betich/tastebox/(commit log)

2026-04-14 feat: update arduino sketches
2026-04-14 feat: implement I2C communication for cooker and plating devices, update requirements
2026-04-21 feat: add Cutter and Ingredient devices with I2C communication
    - Implemented CutterDevice class for controlling the cutter hardware via I2C.
    - Implemented IngredientDevice class for managing ingredient dispensing via I2C.
    - Updated PlatingArmDevice to reflect changes in the I2C register map and functionality.
    - Modified master controller to include new devices in the demo and initialization process.
    - Added platformio configuration and main logic for Cutter and Ingredient nodes.
    - Refactored existing code for better readability and maintainability.
2026-05-03 feat: LCD display, admin debug UI, I2C consistency fixes, RPi setup script
    - Fix missing REG_SET_PAN_LO/REG_ARM_DUR_LO (plating) and
    REG_LID_DUR_LO/REG_PST_DUR_LO (cutter) constant definitions;
    update CLAUDE.md register maps to reflect actual pan+arm firmware
    - Add controller/display.py: ST7735 driver via luma.lcd with
    IDLE/PERSONALIZING/COOKING/FINISHED states; cooking state ticks
    an elapsed timer on the display every second
    - Add controller/server.py: Flask HTTP server exposing full REST API
    for all four I2C devices plus POST /state to drive the LCD;
    started as a daemon thread from master.py
    - Add web/app/routes/admin.tsx: /admin debug page with virtual
    gamepad UI (D-pad,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
    [display.py, esp32_drive.ino, main.cpp, master.py, serial_bus.py]
2026-05-03 fix: skip offline I2C devices instead of crashing in demo
    probe_all now returns per-device results so main does not re-probe;
    demo guards each device section and prints OFFLINE skipped for
    missing nodes; partial-offline startup emits a named [WARN] line.
    [master.py]
2026-05-03 fix: remove invalid -q flag from NodeSource bash pipe; improve admin UI labels
    - setup_rpi.sh: bash does not accept -q — caused "No such file or directory" error during Node.js install step
    - admin.tsx: add joystick descriptions, D-pad directional labels, and device status grid
2026-05-03 feat: swap display driver from SPI ST7735 to I2C SSD1306 (0x3C, 0.96" OLED)
    - display.py: replace spi+st7735 with i2c+ssd1306 at 0x3C, 128x64, adjust layout
    - server.py / master.py: rename ST7735Display to SSD1306Display
    - setup_rpi.sh: install luma.oled instead of luma.lcd
    - RPI_SETUP.md: update wiring table from SPI to I2C SDA/SCL
    [display.py, master.py, server.py]
2026-05-03 fix: use absolute imports in device files to fix systemd startup crash
    from ..bus failed when api.py is the entry point because devices/ is
    treated as a top-level package — .. has nothing above it. Absolute
    from bus import matches how master.py already imports.
2026-05-03 fix: initialise display and set IDLE state on api.py startup
    api.py (the systemd entry point) never touched the display, so the
    screen stayed blank. Add SSD1306Display init, set IDLE immediately at
    startup, and expose POST /state so the web UI can update it.
    [api.py]
2026-05-03 refactor: extract controller API calls into controller.server.ts
    Add app/lib/controller.server.ts with setDisplayState, cookerClick,
    cookerSetPosition, platingMove. Update cooking/done/home routes to use
    it. Display now tracks the full flow: idle -> cooking -> finished -> idle.
2026-05-03 feat: tap TASTEBOX logo to open admin, add back button to admin
2026-05-03 fix: joystick commits correct value on tap and drag
    Use a lastVal ref inside Joystick to track the position synchronously.
    Add onCommit prop that fires with the real value on pointer-up, before
    resetting to center — replacing the outer-div onPointerUp wrapper that
    read stale React state and always sent 50 on a quick tap.
2026-05-03 feat: ESP32 stepper driver sketch (ENA/DIR/PUL, serial commands)
    GPIO16=ENA GPIO17=DIR GPIO18=PUL. Commands: ENABLE, DISABLE,
    MOVE <steps>, SPEED <us>, STATUS, RESET, X (abort mid-move).
    [esp32_stepper.ino]
2026-05-03 feat: ESP32 stepper driver sketch (ENA/DIR/PUL, serial commands)
    src/main.cpp for PlatformIO; esp32_stepper.ino kept as reference.
    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
    [main.cpp]
2026-05-03 feat: add USB gamepad support via browser Gamepad API
    Polls navigator.getGamepads() each animation frame; wires dpad/face
    buttons and analog sticks to all four routes (home carousel, personalize
    bars, done screen, admin full control + connected indicator).
2026-05-03 fix: always start HTTP server regardless of I2C device presence
    Previously master.py returned early when no devices were found, so the
    Flask API never started and the web UI always showed offline. Now the
    server starts unconditionally, the main thread stays alive (Ctrl-C to
    quit), and the demo is simply skipped when devices are absent.
    [master.py]
2026-05-03 feat: add structured logging to controller (console + rotating file)
    Introduces log.py (setup once in main), replaces all print() calls with
    logging.getLogger(__name__) in master, server, and display. Flask
    after-request handler logs every POST command + status code; device
    errors are logged at WARNING; display state changes at INFO.
    Log file: controller/tastebox.log (5 MB × 3 rotating).
    [display.py, log.py, master.py, server.py]
2026-05-03 fix: switch systemd service entry point from api.py to master.py
    api.py never called log.setup() so only raw werkzeug output appeared
    in journalctl. master.py initialises structured logging first and starts
    the Flask server as a daemon thread.
2026-05-03 feat: add second stepper driver to ingredient node (D9/D10/D11)
    Both drivers run in sync — same DISPENSE/RETRACT/STOP command pulses
    PUL1+PUL2 together at 400 Hz with matching DIR and ENA signals.
2026-05-03 feat: add help command to ingredient serial interface
    Prints all commands, register map, and pin assignments.
    Unknown input now replies with "? (type 'help')".
2026-05-03 feat: add stepper_test PlatformIO draft sketch
    Basic CW/CCW rotation test — 200 steps per revolution at 800 µs delay.
    Pins: STEP=D2, DIR=D3, EN=D4.
2026-05-03 fix: correct EN_PIN polarity and add MICROSTEP_DIV for 17HS4401
    EN is active-low — HIGH disables the driver causing erratic movement.
    Added MICROSTEP_DIV constant to match driver MS switch setting so
    stepsPerRev scales correctly (default: full step = 200 steps/rev).
    [main.cpp]
2026-05-03 fix: A4988 + 17HS4401 debug sketch — stable DIR, continuous stepping
    DIR set before first pulse (avoids floating state), ENABLE held LOW,
    continuous stepping loop with serial toggle for direction.
    Coil wiring documented: 1A/1B=Red/Green, 2A/2B=Yellow/Blue.
    [main.cpp]
2026-05-03 feat: ingredient rework — new commands, API endpoints, admin UI + pin fix
    Python device: fwd/bwd (continuous) + dispense/retract (burst).
    Server: adds /ingredient/fwd and /ingredient/bwd endpoints.
    Admin UI: D-pad ↑↓ = continuous, face A/B = timed burst.
    stepper_test: pins corrected to STEP=2 DIR=3 EN=4 (matches hardware).
    [main.cpp, server.py]
2026-05-03 fix: invert DIR for Stepper A (pins 2/3/4)
    Stepper A runs opposite direction to B for the same command.
    [main.cpp]
2026-05-03 feat: independent A/B stepper control, revolution-based dispensing
    Steppers A (D2/D3/D4) and B (D13/D12/D11) now controlled separately.
    Time-based burst replaced with step-count revolution (default 200 steps,
    adjustable via REG_REV 0x11-0x12 or /ingredient/revolutions API).
    Admin: D-pad ↑↓=A cont, ←→=B cont; face A/B=dispense; X/Y=stop A/B.
    Left stick sets steps/rev (0–400) on release.
    [main.cpp, server.py]
2026-05-03 fix: set default steps/rev to 1600 (1/8 step), revert A dir to match B
    [main.cpp]
2026-05-04 feat: update admin route for plating device commands and status
    - Enhanced StatusData interface to include lid status and busy state for plating device.
    - Updated action handling for plating commands including dispense, retract, and lid operations.
    - Improved status display for plating device to show lid state.
    - Adjusted button mappings for plating device to reflect new commands.
    - Modified joystick controls for plating device to manage arm and lid movements.
    - Updated documentation for button labels and descriptions.
    feat: add arm joint control sketch
    - Introduced a new Arduino sketch for controlling a DC motor arm joint with hard-stop homing via stall detection.
    - Implemented state mach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
    [main.cpp, server.py]
2026-05-06 feat: add RS-485 ping/pong connectivity test
    RPi master (controller/rs485_test.py) pings every 2s via /dev/ttyS0,
    controls DE/RE independently on GPIO23/24, prints RTT or timeout.
    Nano slave (sketches/rs485_test) responds with PONG and blinks LED13.
2026-05-06 feat: add UART loopback test and fix rs485 port to ttyAMA0
    rs485_loopback.py tests raw UART with TX->RX jumper, no MAX485/GPIO.
    rs485_test.py updated to use /dev/ttyAMA0 (PL011) over ttyS0 (mini-UART).
    [rs485_loopback.py]
2026-05-06 feat: add MAX485 self-echo test for TX chain debugging
    Keeps RE LOW during TX so the MAX485 reads back its own bus drive,
    isolating whether the TX chain (UART→MAX485→A/B) is functional.
2026-05-06 chore: change listening time to prevent noise
    [rs485_echo_test.py]
2026-05-06 chore: update print loop
2026-05-07 fix: bridge DE and RE to single GPIO23 on RPi side
    Matches physical wiring where DE and RE are tied together on both
    the RPi MAX485 (GPIO23) and the Nano MAX485 (D2).
    [rs485_echo_test.py, rs485_test.py]
2026-05-07 fix: switch to USB-to-RS485 adapter, remove GPIO DE/RE control
    USB adapter handles DE/RE automatically — no RPi.GPIO needed.
    Port changed from /dev/ttyAMA0 to /dev/ttyUSB0 on both scripts.
    [rs485_echo_test.py, rs485_test.py]
2026-05-07 debug: add BEACON_MODE to Nano RS-485 test for TX chain isolation
    When compiled with -D BEACON_MODE, Nano transmits continuously so
    A/B voltages can be measured without needing to receive a PING first.
2026-05-07 debug: hold DE HIGH for 3s in BEACON_MODE for multimeter measurement
    Makes it possible to measure A/B voltage response to DE with a
    multimeter — LED also lights during the HIGH window as confirmation.
2026-05-07 fix: assert RTS on open to enable DE for USB-to-RS485 adapters
    Some USB-RS485 adapters use RTS to control the DE pin rather than
    auto-switching — force RTS HIGH so the driver is enabled on TX.
    [rs485_test.py]
2026-05-07 fix: update Nano RS-485 pins — RO=D2, DI=D3, DE/RE=D4
    [main.cpp]
2026-05-07 fix: align rs485_test pins with cooker module — RO=D4, DI=D5, DE/RE=D6
    [main.cpp]
2026-05-07 docs: update plating node pins — RS-485 on A0/A1/A2, remove joystick
    Joystick removed; plating is now controlled directly by the Pi.
2026-05-07 fix: update rs485_test pins to plating node — RO=A0, DI=A1, DE/RE=A2
    [main.cpp]
2026-05-07 docs: add cutter node RS-485 pins — RO=D2, DI=D3, DE/RE=D4
2026-05-07 docs/fix: add ingredient RS-485 pins RO=D5/DI=D6/DE+RE=D7, update sketch
    [main.cpp]
2026-05-07 feat: migrate all 4 nodes to RS485, add Python lib/, update admin UI
    Arduino nodes:
    - plating, ingredient, cutter: Wire→RS485Node migration matching cooker pattern
    - cutter: full hardware rewrite for new peripherals (door/clamp/roller/
    scissor/pepper/pump/salt), all via RS485 node 0x45
    - all platformio.ini: add lib_extra_dirs = ../shared_lib
    Python controller:
    - controller/lib/: new RS485Bus (thread-safe, retries, interceptor chain),
    CommandInterceptor base, protocol.py pure encode/decode functions,
    lib/devices/ with duck-typed BaseDevice and all 4 device classes
    - lib/devices/cutter.py: new register map and methods for new hardware
    - master.py: add main_rs485() + --rs485 [port] fla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
2026-05-07 feat: add USB serial control to all nodes + strategy pattern in lib/
    Arduino (shared lib):
    - New SerialFrameHandler — same @{ADDR} R/W frame protocol as RS485Node
    but over any Stream& (no DE/RE); mirrors the setDefaultReadHandler /
    setDefaultWriteHandler API of RS485Node
    - All 4 nodes: include SerialFrameHandler, declare serial_handler(ADDR),
    wire handlers in setup(), call serial_handler.poll(Serial) in loop()
    — RS485 and USB serial now work simultaneously
    Python lib/:
    - lib/node_serial_bus.py: NodeSerialBus — RS485Bus subclass with 0.5s
    default timeout, intended for per-node direct USB serial connections
    - lib/strategy.py: open_rs485 / open_serial_nodes / open_i2c factory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
2026-05-07 fix: scope CMD_LID_OPEN case body to eliminate -fpermissive jump-past-init warning
    uint16_t lid_open_dur declared inside case CMD_LID_OPEN without braces caused
    other switch cases to jump past its initialization.
    [main.cpp]
2026-05-08 feat: add stepper C to ingredient node, fix RS485 echo bug, add /ping endpoint
    - ingredient firmware: add motor C (PUL=D8/DIR=D9/ENA=D10), simultaneous
    3-motor step loop, REG_STATUS_C=0x02, commands 0x0C–0x10
    - ingredient Python device: c_fwd/bwd/dispense/retract/stop_c, is_busy_c,
    status() now reads and returns c_busy
    - server: /ingredient/c/* routes, /ping endpoint (probes all 4 nodes with
    timing), remove duplicate ping_all, fix /status ingredient fields to
    a_busy/b_busy/c_busy
    - rs485_bus: add _readline_valid() to skip adapter echo frames before
    reading the real node response — fixes all devices showing as not found
    when using a CH340/CP2102 adapter that echoes TX bytes on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
    [main.cpp, rs485_check.py, server.py]
2026-05-08 fix: make RS485 the default mode; fix systemd service and Docker host routing
    - master.py: RS485 on /dev/ttyUSB0 is now the default; --i2c to opt back in
    - setup_rpi.sh: remove redundant --rs485 flag from ExecStart; add
    --add-host=host.docker.internal:host-gateway to docker run so the web
    container can reach master.py on the Pi host
    - RPI_SETUP.md: replace i2cdetect step with rs485_check.py; update manual
    run commands
    [master.py]
2026-05-08 fix: use --network host for web container so localhost:5000 resolves on Pi
    --add-host requires Docker 20.10+ and doesn't always resolve on Raspberry Pi.
    --network host shares the host network namespace directly — localhost:5000
    reaches master.py without any bridging or DNS tricks.
2026-05-08 feat: redesign admin UI with data-driven controls and gamepad remapping
    Complete rewrite of admin.tsx:
    - Data-driven DEVICE_CONFIG with SubComponent[] per device
    - ActionRows: all sub-rows visible, active full opacity, inactive dimmed 30%
    - FaceCluster: face button visual reference showing mapped actions
    - SubTabs: D-pad up/down to cycle sub-components
    - STICK_USE config drives joystick visibility per device
    - RS485 address labels (RS485 #01-04) replacing I2C hex addresses
    - Cutter updated to new hardware: door/clamp/roller/scissor/dispensers
    - Gamepad: LB/RB + D-pad lr cycle devices; D-pad ud cycle sub-components; face = actions
2026-05-08 fix: remap D-pad lr to cycle sub-components, LB/RB cycle devices
2026-05-08 fix: poll RS485 between steps to prevent STOP being buried; debounce UI send 250ms
    [main.cpp]
2026-05-08 fix: plating arm/lid speed tuning and label swap
    - ARM_PWM_FWD=50 (dispense 75% slower), ARM_PWM_BWD=128 (retract 50% slower via brake-mode PWM)
    - LID_PWM_SPEED=20 (lid 50% slower)
    - Swap Dispense/Retract labels on plating arm to match physical direction
    [main.cpp]
2026-05-08 feat: add fixed E-STOP button with ON/OFF toggle to admin screen
    Sends parallel stop commands to all devices (arm/lid/ingredient/roller/scissor/pump).
    Toggle flips to OFF on click; can be manually reset to ON.
2026-05-10 feat: switch to USB-primary communication with RS-485 as secondary
    All four Arduino nodes now poll USB (HardwareSerial) before RS-485
    (SoftwareSerial) in every loop iteration, making USB the primary path.
    RS-485 remains fully active as a secondary/debug channel.
    Controller:
    - Default startup mode is now USB auto-discovery (python master.py with
    no args scans /dev/ttyUSB* and /dev/ttyACM* at 115200 baud, maps each
    port to its node address via the ASCII register protocol)
    - _NullBus placeholder keeps unfound nodes as 'offline' without crashing
    - Optional --rs485-monitor <port> flag enables a background thread that
    probes nodes via RS-485 every 5 s for the admin debug badge
    - --rs485, --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
    [RS485Node.cpp, RS485Node.h, main.cpp, master.py, server.py]
2026-05-10 feat: USB re-discovery on ping + help command for all nodes
    - /ping triggers background USB re-discovery when any node is offline
    - Only scans for nodes still on _NullBus, won't disturb connected devices
    - live_buses dict tracks open NodeSerialBus for clean shutdown and swapping
    - devices_by_addr maps addr to device object for in-place bus replacement
    Firmware (plating, ingredient, cutter):
    - Added handlePlainText / help command over serial (type 'help')
    - Strings use F() macro to store in flash not SRAM
    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
    [master.py, server.py]
2026-05-10 feat: add test_usb.py — standalone USB node connectivity test
    Discovers nodes, pings each one, reads reg 0x00, prints a summary.
    Exits with code 1 if any node is missing.
    [test_usb.py]
2026-05-10 fix: increase boot wait to 2.5s in USB discovery; add --debug mode to test_usb
    The 0.1s sleep after port open was too short — Arduino resets when the
    port is opened and the optiboot bootloader takes ~1-2s before handing
    off to the sketch. Increased BOOT_WAIT to 2.5s.
    test_usb --debug dumps raw startup output and probe responses per port
    to diagnose timing or baud rate issues without needing tio.
    [test_usb.py]
2026-05-10 fix: halve pan stepper speed; set UI pan step to 50 (0x32)
    [main.cpp]
2026-05-10 fix: lower pan speed to 1.875 deg/s; set UI pan step to 400
    [main.cpp]
2026-05-10 fix: pan buttons → quarter/half steps; joystick → degree scale (full=±360°)
2026-05-10 fix: set default lid duration to 19500ms
    [main.cpp]
2026-05-10 feat: add USB scan button and live status indicators to admin UI
    - POST /scan endpoint triggers USB rediscovery synchronously
    - "Scan USB" button in admin header with "Scanning…" disabled state
    - Amber banner below device grid while scan is in progress (~5s)
    - Status dot pulses while status is being refreshed
    - Status grid auto-reloads immediately after ping or scan completes
2026-05-11 feat: add runtime step speed control for ingredient motors
    Firmware: add REG_SPD_HI/LO (0x13/0x14) to set step half-delay in µs
    at runtime (default 800µs ≈ 625 Hz). Replaces hardcoded STEP_HALF_US.
    Python: IngredientDevice.set_speed(half_us) writes the new register.
    Server: POST /ingredient/speed endpoint.
    Admin: right joystick on ingredient page commits step speed —
    up (100) = 200µs fast, center (50) = 800µs default, down (0) = 1400µs slow.
    [main.cpp, server.py]
2026-05-11 feat: add automated cook sequence with E-STOP to cooking page
    7-step background sequence (ingredients → cut → lid → cooker on →
    4-min cook → cooker off → plate) runs in a Flask daemon thread.
    New endpoints: POST /cook/start, GET /cook/status, POST /cook/estop.
    Cooking page polls status every 2 s, shows step dots + live label,
    circular countdown only during the cooking step, and a fixed E-STOP
    button that immediately halts all hardware.
    [server.py]
2026-05-11 feat: add stop pan button and pan angle slider to admin UI
    Adds /plating/pan/stop endpoint and a Stop button in the Pan sub.
    Pan slider snaps to 7 discrete positions (−full/−½/−¼/0/¼/½/full)
    with a confirm Move button; resets to centre after each move.
    [server.py]
